ODGrip/Microwave_LO_Generator/README.md

# Microwave_LO_Generator
23.3 GHz - 26.3 GHz LO generator

View on CADLAB.io: https://cadlab.io/projects/microwavelogenerator
