ODGrip/Microwave_LO_Generator/CPWG.png

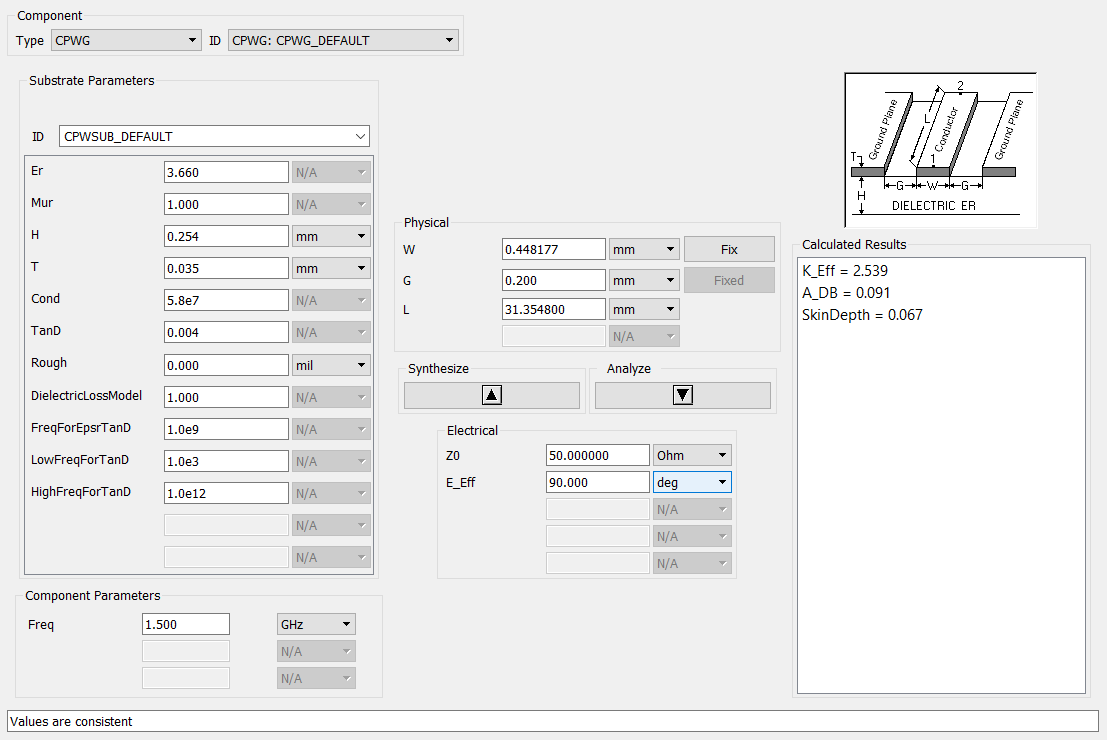
CPWG.png
