ODGrip/Microwave_LO_Generator/Microwave_LO_Generator/Microwave_LO_Generator.xlsx

Reference | Value | Manufacturer/Part Number | Supplier Stock Code | Footprint | Datasheet
C1 | 10p | 04025A100JAT2A | 581-04025A100J | Capacitor_SMD:C_0402_1005Metric_Pad0.74x0.62mm_HandSolder | ~
C10 | 10p | 04025A100JAT2A | 581-04025A100J | Capacitor_SMD:C_0402_1005Metric_Pad0.74x0.62mm_HandSolder | ~
C11 | 330p | GRM022R71C331KE14L | 81-GRM022R71C331KE4L | Capacitor_SMD:C_0402_1005Metric_Pad0.74x0.62mm_HandSolder | ~
C12 | 5.60n | GCM155R71H562JA55D | 81-GCM155R71H562JA5D | Capacitor_SMD:C_0402_1005Metric_Pad0.74x0.62mm_HandSolder | ~
C13 | 120p | 04023A121JAT2A | 581-04023A121JAT2A | Capacitor_SMD:C_0402_1005Metric_Pad0.74x0.62mm_HandSolder | ~
C14 | 1u | 963-GMK105CC6105MV-F | GMK105CC6105MV-F | Capacitor_SMD:C_0402_1005Metric_Pad0.74x0.62mm_HandSolder | ~
C15 | 100p | 04025C101KAT2A | 581-04025C101KAT2A | Capacitor_SMD:C_0402_1005Metric_Pad0.74x0.62mm_HandSolder | ~
C16 | 100p | 04025C101KAT2A | 581-04025C101KAT2A | Capacitor_SMD:C_0402_1005Metric_Pad0.74x0.62mm_HandSolder | ~
C17 | 1u | GMK105CC6105MV-F | 963-GMK105CC6105MV-F | Capacitor_SMD:C_0402_1005Metric_Pad0.74x0.62mm_HandSolder | ~
C18 | 4.7u | 0402YD475MAT2A | 581-0402YD475MAT2A | Capacitor_SMD:C_0402_1005Metric_Pad0.74x0.62mm_HandSolder | ~
C19 | 4.7u | 0402YD475MAT2A | 581-0402YD475MAT2A | Capacitor_SMD:C_0402_1005Metric_Pad0.74x0.62mm_HandSolder | ~
C2 | 0.1u | 581-0402YD104MAT2A | 0402YD104MAT2A | Capacitor_SMD:C_0402_1005Metric_Pad0.74x0.62mm_HandSolder | ~
C20 | 4.7u | 0402YD475MAT2A | 581-0402YD475MAT2A | Capacitor_SMD:C_0402_1005Metric_Pad0.74x0.62mm_HandSolder | ~
C21 | 100p | GCM1555C1H101JA16D | 81-GCM1555C1H101JA6D | Capacitor_SMD:C_0402_1005Metric_Pad0.74x0.62mm_HandSolder | ~
C22 | 100p | GCM1555C1H101JA16D | 81-GCM1555C1H101JA6D | Capacitor_SMD:C_0402_1005Metric_Pad0.74x0.62mm_HandSolder | ~
C23 | 100p | GCM1555C1H101JA16D | 81-GCM1555C1H101JA6D | Capacitor_SMD:C_0402_1005Metric_Pad0.74x0.62mm_HandSolder | ~
C24 | 10n | 0402YC103KAT4A | 581-0402YC103KAT4A | Capacitor_SMD:C_0402_1005Metric_Pad0.74x0.62mm_HandSolder | ~
C25 | 10n | 0402YC103KAT4A | 581-0402YC103KAT4A | Capacitor_SMD:C_0402_1005Metric_Pad0.74x0.62mm_HandSolder | ~
C26 | 10n | 0402YC103KAT4A | 581-0402YC103KAT4A | Capacitor_SMD:C_0402_1005Metric_Pad0.74x0.62mm_HandSolder | ~
C27 | 3.3u | C1005X5R1A335K050BC | 810-C1005X5R1A335K0C | Capacitor_SMD:C_0402_1005Metric_Pad0.74x0.62mm_HandSolder | ~
C28 | 3.3u | C1005X5R1A335K050BC | 810-C1005X5R1A335K0C | Capacitor_SMD:C_0402_1005Metric_Pad0.74x0.62mm_HandSolder | ~
C29 | 3.3u | C1005X5R1A335K050BC | 810-C1005X5R1A335K0C | Capacitor_SMD:C_0402_1005Metric_Pad0.74x0.62mm_HandSolder | ~
C3 | 1n | 04025C102JAT2A | 581-04025C102J | Capacitor_SMD:C_0402_1005Metric_Pad0.74x0.62mm_HandSolder | ~
C30 | 4.7u | 0402YD475MAT2A | 581-0402YD475MAT2A | Capacitor_SMD:C_0402_1005Metric_Pad0.74x0.62mm_HandSolder | ~
C31 | 100p | GCM1555C1H101JA16D | 81-GCM1555C1H101JA6D | Capacitor_SMD:C_0402_1005Metric_Pad0.74x0.62mm_HandSolder | ~
C32 | 1000p | TMK063CG102JT-F | 963-TMK063CG102JT-F | Capacitor_SMD:C_0201_0603Metric_Pad0.64x0.40mm_HandSolder | ~
C33 | 100p | GCM1555C1H101JA16D | 81-GCM1555C1H101JA6D | Capacitor_SMD:C_0402_1005Metric_Pad0.74x0.62mm_HandSolder | ~
C34 | 4.7u | 0402YD475MAT2A | 581-0402YD475MAT2A | Capacitor_SMD:C_0402_1005Metric_Pad0.74x0.62mm_HandSolder | ~
C4 | 100p | GCM1555C1H101JA16D | 81-GCM1555C1H101JA6D | Capacitor_SMD:C_0402_1005Metric_Pad0.74x0.62mm_HandSolder | ~
C5 | 0.1u | 581-0402YD104MAT2A | 0402YD104MAT2A | Capacitor_SMD:C_0402_1005Metric_Pad0.74x0.62mm_HandSolder | ~
C6 | 10p | 04025A100JAT2A | 581-04025A100J | Capacitor_SMD:C_0402_1005Metric_Pad0.74x0.62mm_HandSolder | ~
C7 | 0.1u | 581-0402YD104MAT2A | 0402YD104MAT2A | Capacitor_SMD:C_0402_1005Metric_Pad0.74x0.62mm_HandSolder | ~
C8 | 1u | 963-GMK105CC6105MV-F | GMK105CC6105MV-F | Capacitor_SMD:C_0402_1005Metric_Pad0.74x0.62mm_HandSolder | ~
C9 | 10p | 04025A100JAT2A | 581-04025A100J | Capacitor_SMD:C_0402_1005Metric_Pad0.74x0.62mm_HandSolder | ~
D1 | LED | HSMG-C170 | 630-HSMG-C170 | LED_SMD:LED_0805_2012Metric_Pad1.15x1.40mm_HandSolder | https://www.mouser.it/datasheet/2/678/av02-0551en-ds-hsmx-cxxx-05mar2012-1827675.pdf
D2 | DIODE | SM4004-W | 583-SM4004 | Diode_SMD:D_MELF | https://www.mouser.it/datasheet/2/395/LL4001G_SERIES_F2004-1918145.pdf
D3 | DIODE | SM4004-W | 583-SM4004 | Diode_SMD:D_MELF | https://www.mouser.it/datasheet/2/395/LL4001G_SERIES_F2004-1918145.pdf
D4 | LED | AP2012HD | 604-AP2012HD | LED_SMD:LED_0805_2012Metric_Pad1.15x1.40mm_HandSolder | https://www.mouser.it/datasheet/2/678/av02-0551en-ds-hsmx-cxxx-05mar2012-1827675.pdf
J1 | Conn_01x05_Male |  |  | Connector_PinHeader_2.54mm:PinHeader_1x05_P2.54mm_Vertical | ~
J2 | Conn_01x02_Male |  |  | Connector_PinHeader_2.54mm:PinHeader_1x02_P2.54mm_Vertical | ~
J3 | Conn_01x02_Male |  |  | Connector_PinHeader_2.54mm:PinHeader_1x02_P2.54mm_Vertical | ~
J4 | Conn_01x02_Female |  |  | Microwave_LO_Generator:Connettore | ~
J5 | Conn_01x02_Female |  |  | Microwave_LO_Generator:Connettore | ~
R1 | 10k |  | in dipartimento | Resistor_SMD:R_0402_1005Metric_Pad0.72x0.64mm_HandSolder | ~
R10 | 7.5k |  | in dipartimento | Resistor_SMD:R_0402_1005Metric_Pad0.72x0.64mm_HandSolder | ~
R11 | 10r |  | in dipartimento | Resistor_SMD:R_0402_1005Metric_Pad0.72x0.64mm_HandSolder | ~
R12 | 1K8 |  | in dipartimento | Resistor_SMD:R_0402_1005Metric_Pad0.72x0.64mm_HandSolder | ~
R13 | 300r |  | in dipartimento | Resistor_SMD:R_0402_1005Metric_Pad0.72x0.64mm_HandSolder | ~
R14 | 1K |  | in dipartimento | Resistor_SMD:R_0402_1005Metric_Pad0.72x0.64mm_HandSolder | ~
R15 | 100r |  | in dipartimento | Microwave_LO_Generator:R_0201_0603_HandSolder_mod | ~
R16 | 0r |  | in dipartimento | Microwave_LO_Generator:R_0201_0603_HandSolder_mod | ~
R17 | 100r |  | in dipartimento | Microwave_LO_Generator:R_0201_0603_HandSolder_mod | ~
R18 | 100r |  | in dipartimento | Microwave_LO_Generator:R_0201_0603_HandSolder_mod | ~
R19 | 100r |  | in dipartimento | Microwave_LO_Generator:R_0201_0603_HandSolder_mod | ~
R2 | 0 |  | in dipartimento | Resistor_SMD:R_0402_1005Metric_Pad0.72x0.64mm_HandSolder | ~
R3 | 10k |  | in dipartimento | Resistor_SMD:R_0402_1005Metric_Pad0.72x0.64mm_HandSolder | ~
R4 | 10k |  | in dipartimento | Resistor_SMD:R_0402_1005Metric_Pad0.72x0.64mm_HandSolder | ~
R5 | 10k |  | in dipartimento | Resistor_SMD:R_0402_1005Metric_Pad0.72x0.64mm_HandSolder | ~
R6 | DNI |  | in dipartimento | Resistor_SMD:R_0402_1005Metric_Pad0.72x0.64mm_HandSolder | ~
R7 | 4.64k |  | in dipartimento | Resistor_SMD:R_0402_1005Metric_Pad0.72x0.64mm_HandSolder | ~
R8 | 1k |  | in dipartimento | Resistor_SMD:R_0402_1005Metric_Pad0.72x0.64mm_HandSolder | ~
R9 | 2.61k |  | in dipartimento | Resistor_SMD:R_0402_1005Metric_Pad0.72x0.64mm_HandSolder | ~
TP1 | TestPoint | 5007 | Mouser 534-5007 | TestPoint:TestPoint_Loop_D2.60mm_Drill1.6mm_Beaded | https://www.mouser.it/datasheet/2/215/005-5009-741293.pdf
TP2 | TestPoint | 5007 | Mouser 534-5007 | TestPoint:TestPoint_Loop_D2.60mm_Drill1.6mm_Beaded | https://www.mouser.it/datasheet/2/215/005-5009-741293.pdf
TP3 | TestPoint | 5007 | Mouser 534-5007 | TestPoint:TestPoint_Loop_D2.60mm_Drill1.6mm_Beaded | https://www.mouser.it/datasheet/2/215/005-5009-741293.pdf
TP4 | TestPoint | 5007 | Mouser 534-5007 | TestPoint:TestPoint_Loop_D2.60mm_Drill1.6mm_Beaded | https://www.mouser.it/datasheet/2/215/005-5009-741293.pdf
TP5 | TestPoint | 5007 | Mouser 534-5007 | TestPoint:TestPoint_Loop_D2.60mm_Drill1.6mm_Beaded | https://www.mouser.it/datasheet/2/215/005-5009-741293.pdf
TP6 | TestPoint | 5007 | Mouser 534-5007 | TestPoint:TestPoint_Loop_D2.60mm_Drill1.6mm_Beaded | https://www.mouser.it/datasheet/2/215/005-5009-741293.pdf
U1 | ADF4150HV | ADF4150HVBCPZ | 584-ADF4150HVBCPZ | Microwave_LO_Generator:LFCSP-32-1EP_5x5mm_P0.5mm_mod | https://www.analog.com/media/en/technical-documentation/data-sheets/ADF4150HV.pdf
U2 | LT3010 | LT3010EMS8E#PBF | 584-LT3010EMS8E#PBF | Package_SO:MSOP-8-1EP_3x3mm_P0.65mm_EP1.68x1.88mm | https://www.analog.com/media/en/technical-documentation/data-sheets/30105fe.pdf
U3 | LT1962-3.3 | LT1962EMS8-3.3#PBF | 584-1962EMS8-3.3PBF | Package_SO:MSOP-8_3x3mm_P0.65mm | https://www.analog.com/media/en/technical-documentation/data-sheets/1962fb.pdf
U4 | LT1962-5 | LT1962EMS8-5#PBF | 584-LT1962EMS8-5#PBF | Package_SO:MSOP-8_3x3mm_P0.65mm | https://www.analog.com/media/en/technical-documentation/data-sheets/1962fb.pdf
U5 | LT1962-5 | LT1962EMS8-5#PBF | 584-LT1962EMS8-5#PBF | Package_SO:MSOP-8_3x3mm_P0.65mm | https://www.analog.com/media/en/technical-documentation/data-sheets/1962fb.pdf
U6 | HMC739LP4E | HMC739LP4E | 584-HMC739LP4E | Microwave_LO_Generator:QFN-24-1EP_4x4mm_P0.5mm_EP2.7x2.7mm_ThermalVias_mod | https://www.mouser.it/datasheet/2/609/hmc739-1504131.pdf
X1 | IQXT-220-1 | IQXT-220-1 | LFTCXO075792Cutt | Oscillator:Oscillator_SMD_Abracon_ASE-4Pin_3.2x2.5mm_HandSoldering | https://www.mouser.it/datasheet/2/741/LFTCXO075792Cutt-1115708.pdf
