ODGrip/Microwave_LO_Generator/Microwave_LO_Generator/Microwave_LO_Generator.kicad_pcb

## KiCad design Microwave_LO_Generator/Microwave_LO_Generator.kicad_pcb (2021-01-16)

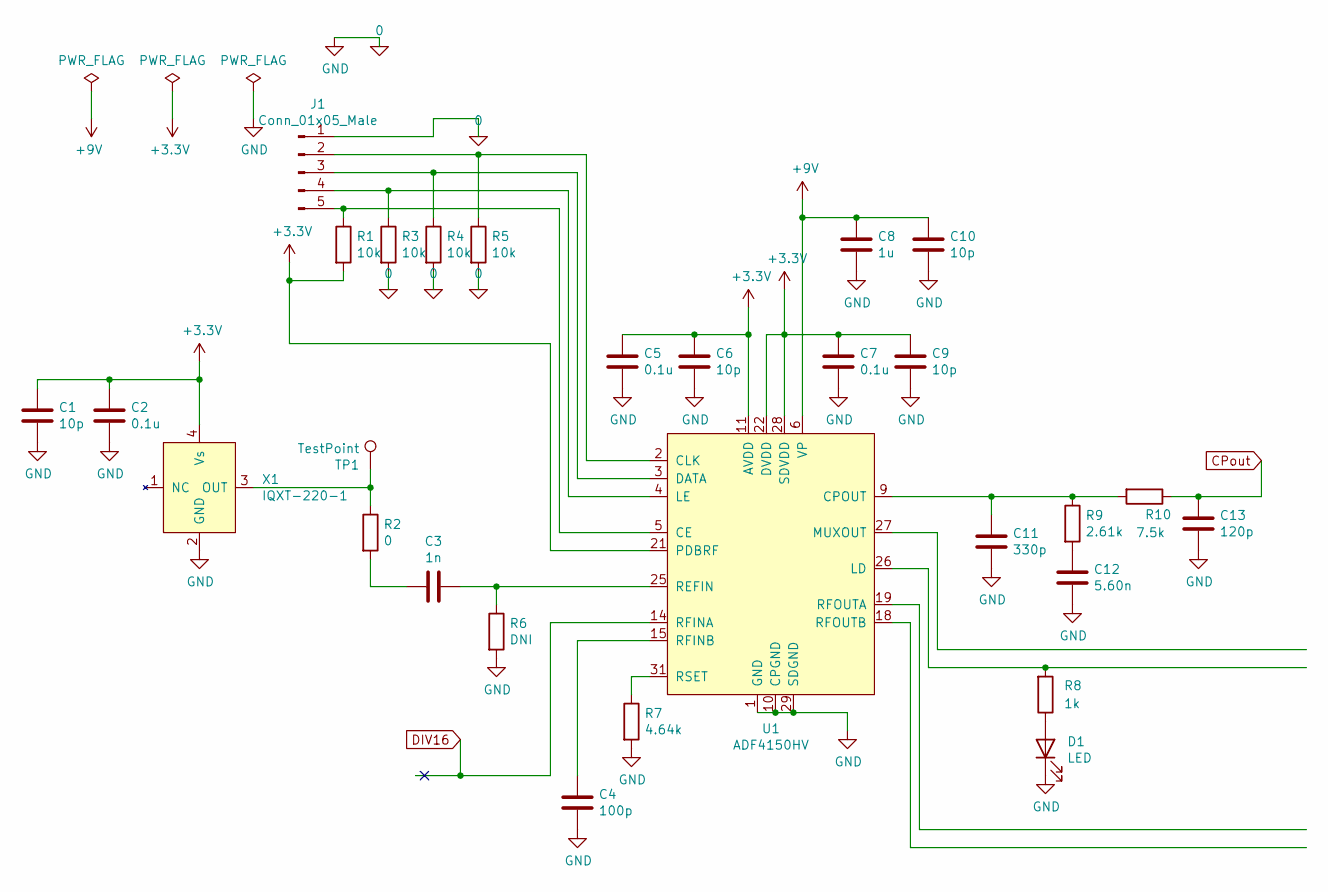
[picture p2: schematic frequencySynthesizer.sch, Frequency Synthesizer]

Parts:
C1, C6, C9, C10: 10p; C_0402_1005Metric_Pad0.74x0.62mm_HandSolder
C2, C5, C7: 0.1u; C_0402_1005Metric_Pad0.74x0.62mm_HandSolder
C3: 1n; C_0402_1005Metric_Pad0.74x0.62mm_HandSolder
C4: 100p; C_0402_1005Metric_Pad0.74x0.62mm_HandSolder
C8: 1u; C_0402_1005Metric_Pad0.74x0.62mm_HandSolder
C11: 330p; C_0402_1005Metric_Pad0.74x0.62mm_HandSolder
C12: 5.60n; C_0402_1005Metric_Pad0.74x0.62mm_HandSolder
C13: 120p; C_0402_1005Metric_Pad0.74x0.62mm_HandSolder
D1: LED; LED_0805_2012Metric_Pad1.15x1.40mm_HandSolder
J1: Conn_01x05_Male; PinHeader_1x05_P2.54mm_Vertical
R1, R3, R4, R5: 10k; R_0402_1005Metric_Pad0.72x0.64mm_HandSolder
R2: 0; R_0402_1005Metric_Pad0.72x0.64mm_HandSolder
R6: DNI; R_0402_1005Metric_Pad0.72x0.64mm_HandSolder
R7: 4.64k; R_0402_1005Metric_Pad0.72x0.64mm_HandSolder
R8: 1k; R_0402_1005Metric_Pad0.72x0.64mm_HandSolder
R9: 2.61k; R_0402_1005Metric_Pad0.72x0.64mm_HandSolder
R10: 7.5k; R_0402_1005Metric_Pad0.72x0.64mm_HandSolder
TP1: TestPoint; TestPoint_Loop_D2.60mm_Drill1.6mm_Beaded
U1: ADF4150HV; LFCSP-32-1EP_5x5mm_P0.5mm_mod
X1: IQXT-220-1; Oscillator_SMD_Abracon_ASE-4Pin_3.2x2.5mm_HandSoldering

Connections:
0: C1.1, C2.1, C4.1, C5.1, C6.1, C7.1, C8.1, C9.1, C10.1, C11.1, C12.1, C13.1, D1.1 (K), J1.1, R3.2, R4.2, R5.2, R6.2, R7.2, U1.1 (GND), U1.7 (GND), U1.8 (GND), U1.10 (CPGND), U1.12 (GND), U1.16 (GND), U1.17 (GND), U1.23 (GND), U1.24 (GND), U1.29 (SDGND), U1.30 (GND), U1.32 (GND), X1.2 (GND); also elsewhere on the board
+3V3: C1.2, C2.2, C5.2, C6.2, C7.2, C9.2, R1.2, U1.11 (AVDD), U1.13 (AVDD), U1.20 (AVDD), U1.21 (PDBRF), U1.22 (DVDD), U1.28 (SDVDD), X1.4 (Vs); also elsewhere on the board
+9V: C8.2, C10.2, U1.6 (VP); also elsewhere on the board
CPout: C13.2, R10.1; also elsewhere on the board
DIV16: U1.14 (RFINA); also elsewhere on the board
unnamed: C3.1, R6.1, U1.25 (REFIN)
unnamed: C3.2, R2.2
unnamed: C4.2, U1.15 (RFINB)
unnamed: C11.2, R9.1, R10.2, U1.9 (CPOUT)
unnamed: C12.2, R9.2
unnamed: D1.2 (A), R8.1
unnamed: J1.2, R5.1, U1.2 (CLK)
unnamed: J1.3, R4.1, U1.3 (DATA)
unnamed: J1.4, R3.1, U1.4 (LE)
unnamed: J1.5, R1.1, U1.5 (CE)
unnamed: R2.1, TP1.1, X1.3 (OUT)
unnamed: R7.1, U1.31 (RSET)
unnamed: R8.2, U1.26 (LD)

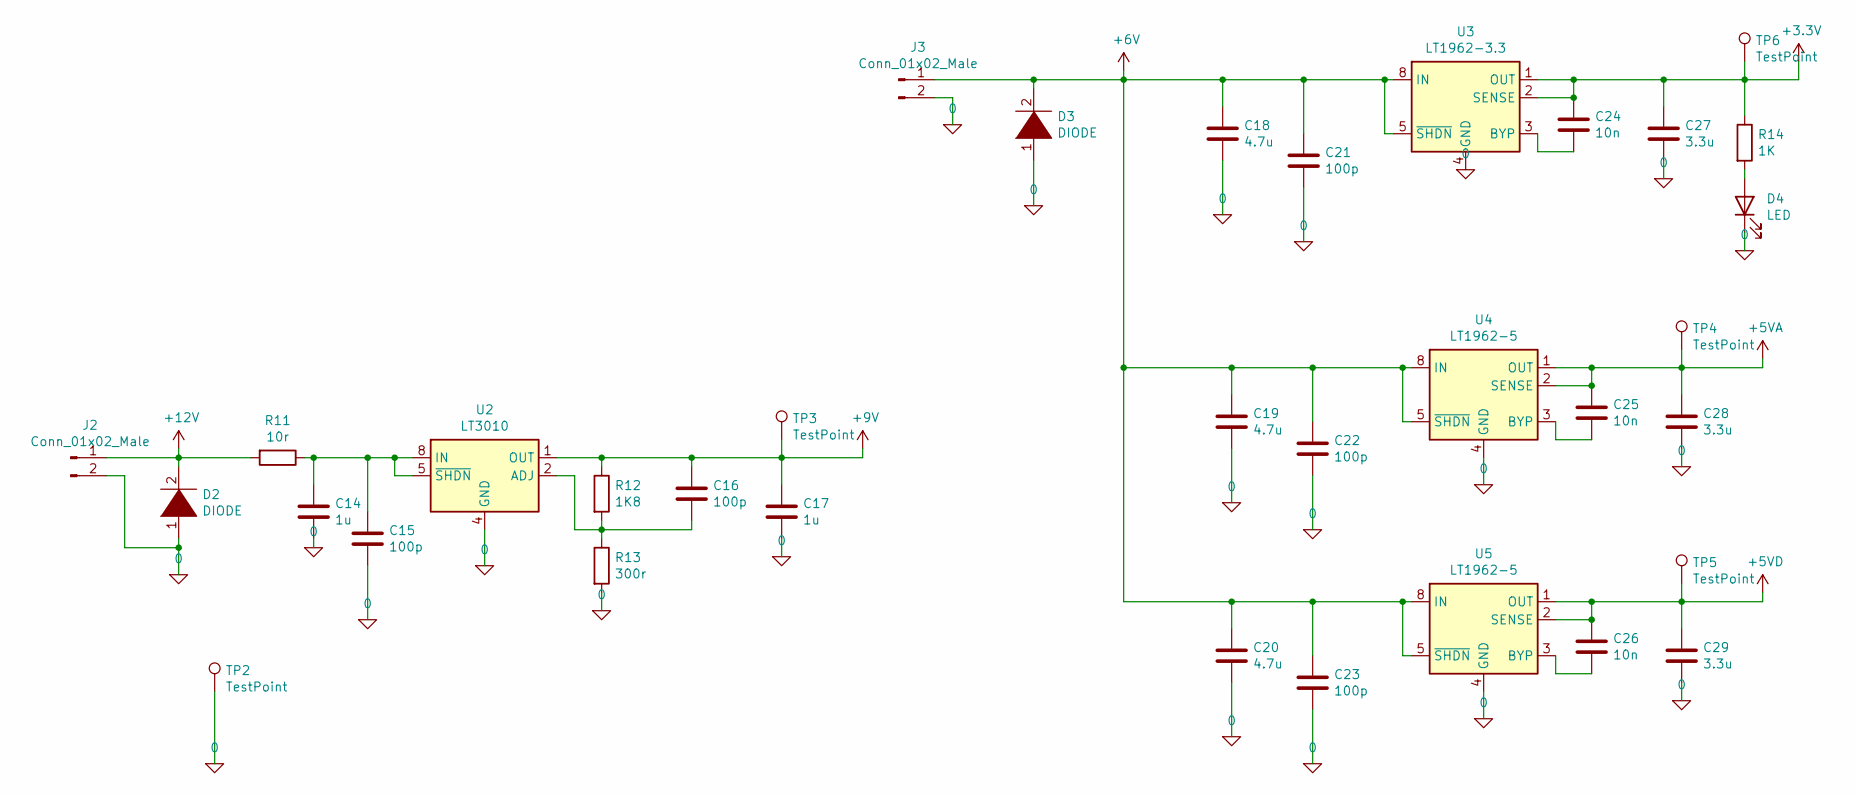
[picture p3: schematic powerSupply.sch]

Parts:
C14, C17: 1u; C_0402_1005Metric_Pad0.74x0.62mm_HandSolder
C15, C16, C21, C22, C23: 100p; C_0402_1005Metric_Pad0.74x0.62mm_HandSolder
C18, C19, C20: 4.7u; C_0402_1005Metric_Pad0.74x0.62mm_HandSolder
C24, C25, C26: 10n; C_0402_1005Metric_Pad0.74x0.62mm_HandSolder
C27, C28, C29: 3.3u; C_0402_1005Metric_Pad0.74x0.62mm_HandSolder
D2, D3: DIODE; D_MELF
D4: LED; LED_0805_2012Metric_Pad1.15x1.40mm_HandSolder
J2, J3: Conn_01x02_Male; PinHeader_1x02_P2.54mm_Vertical
R11: 10r; R_0402_1005Metric_Pad0.72x0.64mm_HandSolder
R12: 1K8; R_0402_1005Metric_Pad0.72x0.64mm_HandSolder
R13: 300r; R_0402_1005Metric_Pad0.72x0.64mm_HandSolder
R14: 1K; R_0402_1005Metric_Pad0.72x0.64mm_HandSolder
TP2, TP3, TP4, TP5, TP6: TestPoint; TestPoint_Loop_D2.60mm_Drill1.6mm_Beaded
U2: LT3010; MSOP-8-1EP_3x3mm_P0.65mm_EP1.68x1.88mm
U3: LT1962-3.3; MSOP-8_3x3mm_P0.65mm
U4, U5: LT1962-5; MSOP-8_3x3mm_P0.65mm

Connections:
0: C14.1, C15.1, C17.1, C18.1, C19.1, C20.1, C21.1, C22.1, C23.1, C27.1, C28.1, C29.1, D2.1 (K), D3.1 (K), D4.1 (K), J2.2, J3.2, R13.2, TP2.1, U2.4 (GND), U2.9 (GND), U3.4 (GND), U4.4 (GND), U5.4 (GND); also elsewhere on the board
+3V3: C24.2, C27.2, R14.1, TP6.1, U3.1 (OUT), U3.2 (SENSE); also elsewhere on the board
+5VA: C25.2, C28.2, TP4.1, U4.1 (OUT), U4.2 (SENSE); also elsewhere on the board
+5VD: C26.2, C29.2, TP5.1, U5.1 (OUT), U5.2 (SENSE); also elsewhere on the board
+6V: C18.2, C19.2, C20.2, C21.2, C22.2, C23.2, D3.2 (A), J3.1, U3.5 (~SHDN), U3.8 (IN), U4.5 (~SHDN), U4.8 (IN), U5.5 (~SHDN), U5.8 (IN)
+9V: C16.2, C17.2, R12.1, TP3.1, U2.1 (OUT); also elsewhere on the board
+12V: D2.2 (A), J2.1, R11.2
unnamed: C14.2, C15.2, R11.1, U2.5 (~SHDN), U2.8 (IN)
unnamed: C16.1, R12.2, R13.1, U2.2 (ADJ)
unnamed: C24.1, U3.3 (BYP)
unnamed: C25.1, U4.3 (BYP)
unnamed: C26.1, U5.3 (BYP)
unnamed: D4.2 (A), R14.2

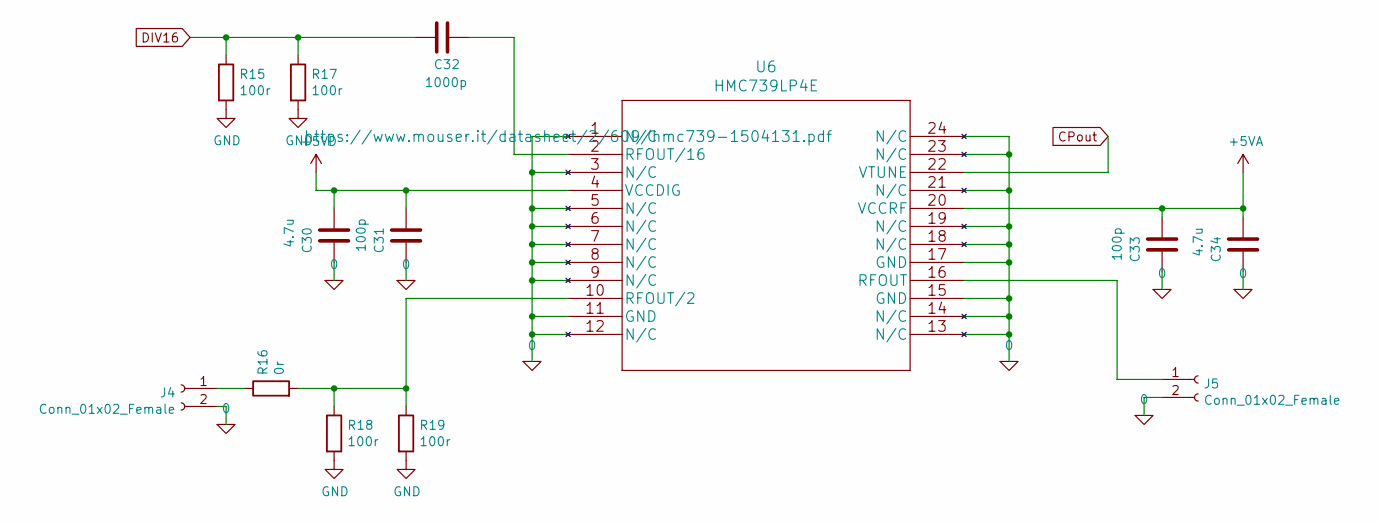
[picture p4: schematic vco.sch]

Parts:
C30, C34: 4.7u; C_0402_1005Metric_Pad0.74x0.62mm_HandSolder
C31, C33: 100p; C_0402_1005Metric_Pad0.74x0.62mm_HandSolder
C32: 1000p; C_0201_0603Metric_Pad0.64x0.40mm_HandSolder
J4, J5: Conn_01x02_Female; Connettore_largo
R15, R17, R18, R19: 100r; R_0201_0603_HandSolder_mod
R16: 0r; R_0201_0603_HandSolder_mod
U6: HMC739LP4E; QFN-24-1EP_4x4mm_P0.5mm_EP2.7x2.7mm_ThermalVias_mod

Connections:
0: C30.2, C31.2, C33.2, C34.2, J4.2, J5.2, R15.2, R17.2, R18.2, R19.2, U6.1 (N/C), U6.3 (N/C), U6.5 (N/C), U6.6 (N/C), U6.7 (N/C), U6.8 (N/C), U6.9 (N/C), U6.11 (GND), U6.12 (N/C), U6.13 (N/C), U6.14 (N/C), U6.15 (GND), U6.17 (GND), U6.18 (N/C), U6.19 (N/C), U6.21 (N/C), U6.23 (N/C), U6.24 (N/C); also elsewhere on the board
+5VA: C33.1, C34.1, U6.20 (VCCRF); also elsewhere on the board
+5VD: C30.1, C31.1, U6.4 (VCCDIG); also elsewhere on the board
CPout: U6.22 (VTUNE); also elsewhere on the board
DIV16: C32.1, R15.1, R17.1; also elsewhere on the board
unnamed: C32.2, U6.2 (RFOUT/16)
unnamed: J4.1, R16.1
unnamed: J5.1, U6.16 (RFOUT)
unnamed: R16.2, R18.1, R19.1, U6.10 (RFOUT/2)

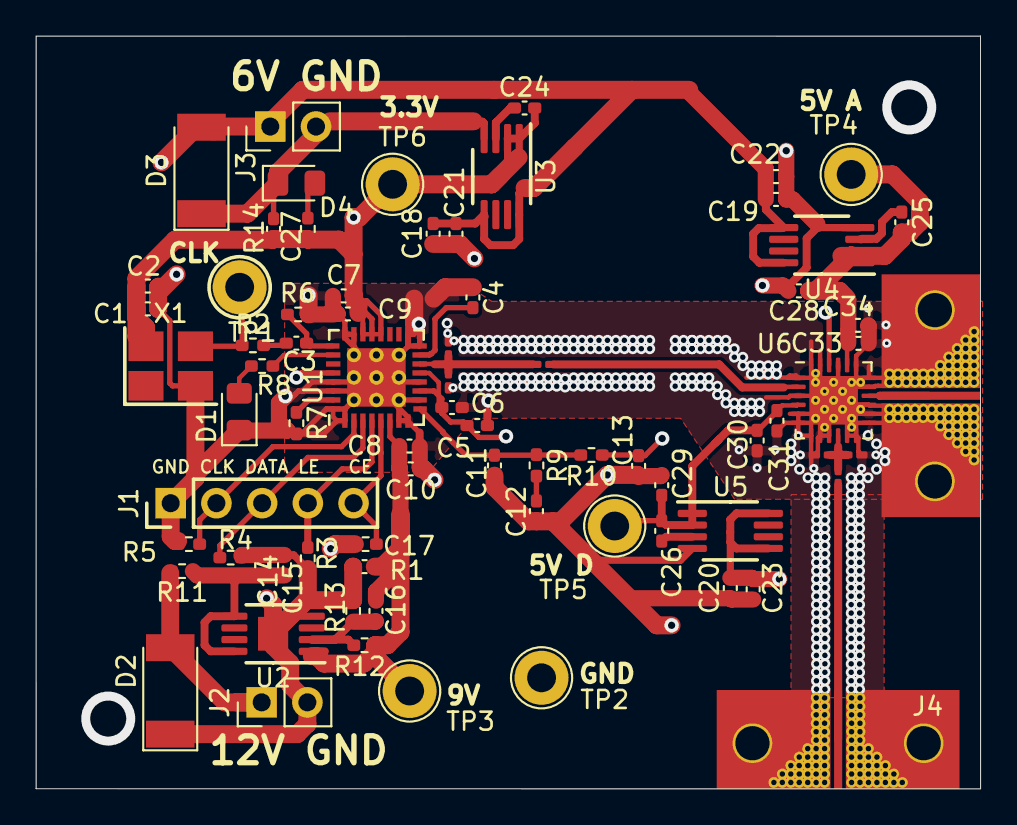
[picture p5: board Microwave_LO_Generator.kicad_pcb from above]

Board: 4 copper layers, 52.5 x 41.8 mm, 75 parts (0 on the bottom side), 32 nets.
