ODGrip/Microwave_LO_Generator/(commit log)

2020-11-24 First commit
    Initial setup
    [Microwave_LO_Generator.kicad_pcb, Microwave_LO_Generator.sch, file5FBE6DB1.sch, file5FBFBF41.sch, frequencySynthesizer.sch, powerSupply.sch]
2020-11-25 add vco
    [Microwave_LO_Generator.kicad_pcb, Microwave_LO_Generator.sch, frequencySynthesizer.sch, powerSupply.sch, vco.sch]
2020-11-25 Update and fix
    [Microwave_LO_Generator.kicad_pcb, file5FBE6DB1.sch, frequencySynthesizer.sch, powerSupply.sch, vco.sch]
2020-11-25 add CADLAB.io link
    [file5FBFBF41.sch]
2020-11-26 Update PCB
    [Microwave_LO_Generator.kicad_pcb]
2020-11-27 Add connector pcb model
    [Microwave_LO_Generator.kicad_pcb, connettore.kicad_pcb]
2020-12-03 Power Supply update
    [Microwave_LO_Generator.kicad_pcb, frequencySynthesizer.sch, powerSupply.sch]
2020-12-04 Add RF/2
    [Microwave_LO_Generator.kicad_pcb, powerSupply.sch, vco.sch]
2020-12-05 A lot of change
    [Microwave_LO_Generator.kicad_pcb, frequencySynthesizer.sch, powerSupply.sch, vco.sch]
2020-12-07 ADD GND test probe
    [Microwave_LO_Generator.kicad_pcb, powerSupply.sch]
2020-12-16 Add stability hole
    [Microwave_LO_Generator.kicad_pcb]
2020-12-16 Edit annular ring
    [Microwave_LO_Generator.kicad_pcb]
2021-01-02 Remove PullDown PDBRF
    [connettore.kicad_pcb]
2021-01-08 update bom
    [Microwave_LO_Generator.kicad_pcb, Microwave_LO_Generator.xlsx, frequencySynthesizer.sch, powerSupply.sch, vco.sch]
2021-01-15 solder clearence + gerber
    [Microwave_LO_Generator-B_Cu.gbr, Microwave_LO_Generator-B_Mask.gbr, Microwave_LO_Generator-Edge_Cuts.gbr, Microwave_LO_Generator-F_Cu.gbr, Microwave_LO_Generator-F_Mask.gbr, Microwave_LO_Generator-F_SilkS.gbr, Microwave_LO_Generator-In1_Cu.gbr, Microwave_LO_Generator-In2_Cu.gbr]
2021-01-15 Change PCB thickness
    [Microwave_LO_Generator-B_Cu.gbr, Microwave_LO_Generator-B_Mask.gbr, Microwave_LO_Generator-Edge_Cuts.gbr, Microwave_LO_Generator-F_Cu.gbr, Microwave_LO_Generator-F_Mask.gbr, Microwave_LO_Generator-F_SilkS.gbr, Microwave_LO_Generator-In1_Cu.gbr, Microwave_LO_Generator-In2_Cu.gbr]
2021-01-16 Update for DRC
    [Microwave_LO_Generator-B_Cu.gbr, Microwave_LO_Generator-B_Mask.gbr, Microwave_LO_Generator-Edge_Cuts.gbr, Microwave_LO_Generator-F_Cu.gbr, Microwave_LO_Generator-F_Mask.gbr, Microwave_LO_Generator-F_SilkS.gbr, Microwave_LO_Generator-In1_Cu.gbr, Microwave_LO_Generator-In2_Cu.gbr]
